ropg/pager/pager.brd

## EAGLE design pager.brd (2017-02-12)

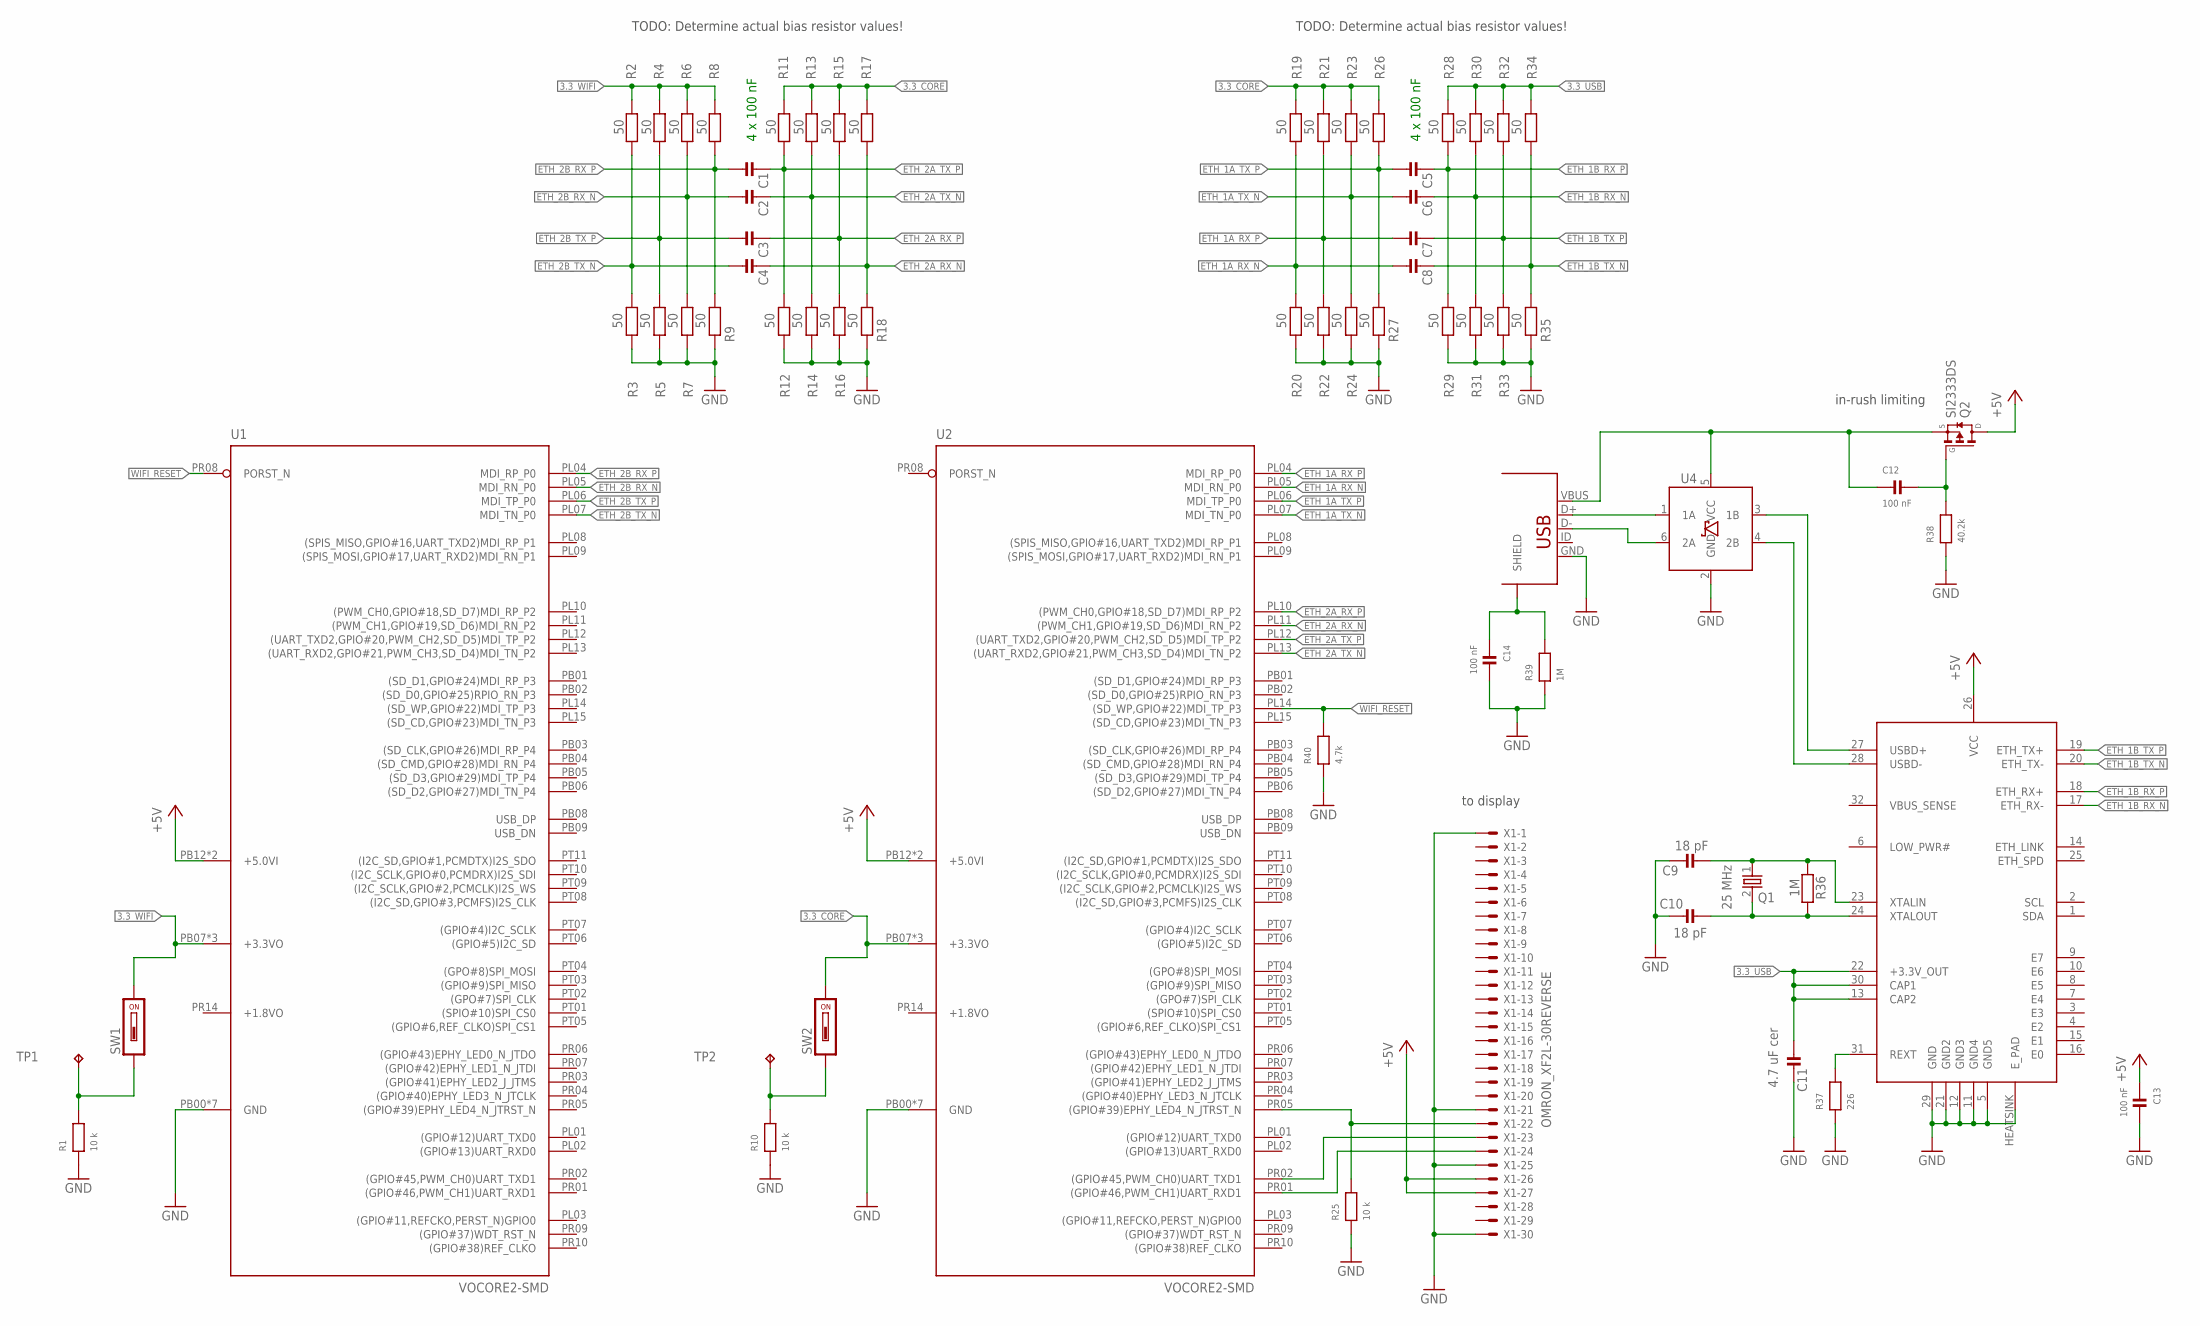
[picture p1: schematic pager.sch]

Parts:
C1, C2, C3, C4, C5, C6, C7, C8, C12, C13, C14: 100 nF; _0402
C9, C10: 18 pF; _0402
C11: 4.7 uF cer; _0603
Q1: 25 MHz; ABM3
Q2: SI2333DS; SOT23
R1, R10, R25: 10 k; _0402
R2, R3, R4, R5, R6, R7, R8, R9, R11, R12, R13, R14, R15, R16, R17, R18, R19, R20, R21, R22, R23, R24, R26, R27, R28, R29, R30, R31, R32, R33, R34, R35: 50; _0402
R36, R39: 1M; _0402
R37: 226; _0402
R38: 40.2k; _0402
R40: 4.7k; _0402
SW1, SW2: CHS-01A1
TP1, TP2: TPTP16SQ; TP16SQ
U1, U2: VOCORE2-SMD
U3: XR22800IL; QFN32
U4: IP4234CZ6; TSOP-6
X1: OMRON_XF2L-30REVERSE; OMRON_XF2L-30
X2: FCI_8193_MICRO_USB; FCI_MICRO_USB_8193

Connections:
3.3_CORE: R11.2, R13.2, R15.2, R17.2, R19.2, R21.2, R23.2, R26.2, SW2.2, U2.PB07 (+3.3VO), U2.PL00 (+3.3VO), U2.PR11 (+3.3VO)
3.3_USB: C11.1, R28.2, R30.2, R32.2, R34.2, U3.13 (CAP2), U3.22 (+3.3V_OUT), U3.30 (CAP1)
3.3_WIFI: R2.2, R4.2, R6.2, R8.2, SW1.2, U1.PB07 (+3.3VO), U1.PL00 (+3.3VO), U1.PR11 (+3.3VO)
+5V: C13.1, Q2.3 (D), U1.PB12 (+5.0VI), U1.PB13 (+5.0VI), U2.PB12 (+5.0VI), U2.PB13 (+5.0VI), U3.26 (VCC), X1.4, X1.5
DISP_RESET: R25.2, U2.PR05 ((GPIO#39)EPHY_LED4_N_JTRST_N), X1.9
DISP_RX0: U2.PR02 ((GPIO#45,PWM_CH0)UART_TXD1), X1.8
DISP_TX0: U2.PR01 ((GPIO#46,PWM_CH1)UART_RXD1), X1.7
ETH_1A_RX_N: C8.1, R19.1, R20.2, U2.PL05 (MDI_RN_P0)
ETH_1A_RX_P: C7.1, R21.1, R22.2, U2.PL04 (MDI_RP_P0)
ETH_1A_TX_N: C6.1, R23.1, R24.2, U2.PL07 (MDI_TN_P0)
ETH_1A_TX_P: C5.1, R26.1, R27.2, U2.PL06 (MDI_TP_P0)
ETH_1B_RX_N: C6.2, R30.1, R31.2, U3.17 (ETH_RX-)
ETH_1B_RX_P: C5.2, R28.1, R29.2, U3.18 (ETH_RX+)
ETH_1B_TX_N: C8.2, R34.1, R35.2, U3.20 (ETH_TX-)
ETH_1B_TX_P: C7.2, R32.1, R33.2, U3.19 (ETH_TX+)
ETH_2A_RX_N: C4.1, R17.1, R18.2, U2.PL11 ((PWM_CH1,GPIO#19,SD_D6)MDI_RN_P2)
ETH_2A_RX_P: C3.1, R15.1, R16.2, U2.PL10 ((PWM_CH0,GPIO#18,SD_D7)MDI_RP_P2)
ETH_2A_TX_N: C2.1, R13.1, R14.2, U2.PL13 ((UART_RXD2,GPIO#21,PWM_CH3,SD_D4)MDI_TN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)
ETH_2A_TX_P: C1.1, R11.1, R12.2, U2.PL12 ((UART_TXD2,GPIO#20,PWM_CH2,SD_D5)MDI_TP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)
ETH_2B_RX_N: C2.2, R6.1, R7.2, U1.PL05 (MDI_RN_P0)
ETH_2B_RX_P: C1.2, R8.1, R9.2, U1.PL04 (MDI_RP_P0)
ETH_2B_TX_N: C4.2, R2.1, R3.2, U1.PL07 (MDI_TN_P0)
ETH_2B_TX_P: C3.2, R4.1, R5.2, U1.PL06 (MDI_TP_P0)
GND: C9.1, C10.1, C11.2, C13.2, C14.2, R1.1, R3.1, R5.1, R7.1, R9.1, R10.1, R12.1, R14.1, R16.1, R18.1, R20.1, R22.1, R24.1, R25.1, R27.1, R29.1, R31.1, R33.1, R35.1, R37.1, R38.1, R39.1, R40.1, U1.PB00 (GND), U1.PB10 (GND), U1.PB11 (GND), U1.PR00 (GND), U1.PR12 (GND), U1.PR13 (GND), U1.PT00 (GND), U2.PB00 (GND), U2.PB10 (GND), U2.PB11 (GND), U2.PR00 (GND), U2.PR12 (GND), U2.PR13 (GND), U2.PT00 (GND), U3.5 (GND5), U3.11 (GND4), U3.12 (GND3), U3.21 (GND2), U3.29 (GND), U3.HEATSINK (E_PAD), U4.2 (GND), X1.1, X1.6, X1.10, X1.30, X2.GND
unnamed: R37.2, U3.31 (REXT)
unnamed: C10.2, Q1.2, R36.2, U3.24 (XTALOUT)
unnamed: C9.2, Q1.1, R36.1, U3.23 (XTALIN)
unnamed: C12.2, Q2.1 (G), R38.2
RAW_+5V: C12.1, Q2.2 (S), U4.5 (VCC), X2.VBUS
SHIELD: C14.1, R39.2, X2.MNT1 (SHIELD), X2.MNT2 (SHIELD), X2.MNT3 (SHIELD), X2.MNT4 (SHIELD), X2.P$1 (SHIELD), X2.P$2 (SHIELD)
USB_N: U3.28 (USBD-), U4.4 (2B)
USB_P: U3.27 (USBD+), U4.3 (1B)
USB_RAW_N: U4.6 (2A), X2.D-
USB_RAW_P: U4.1 (1A), X2.D+
WIFI_RESET: R40.2, U1.PR08 (PORST_N), U2.PL14 ((SD_WP,GPIO#22)MDI_TP_P3)
WP_CORE: R10.2, SW2.1, TP2.TP
WP_WIFI: R1.2, SW1.1, TP1.TP

Notes on the sheet:
in-rush limiting
to display
TODO: Determine actual bias resistor values!
4 x 100 nF

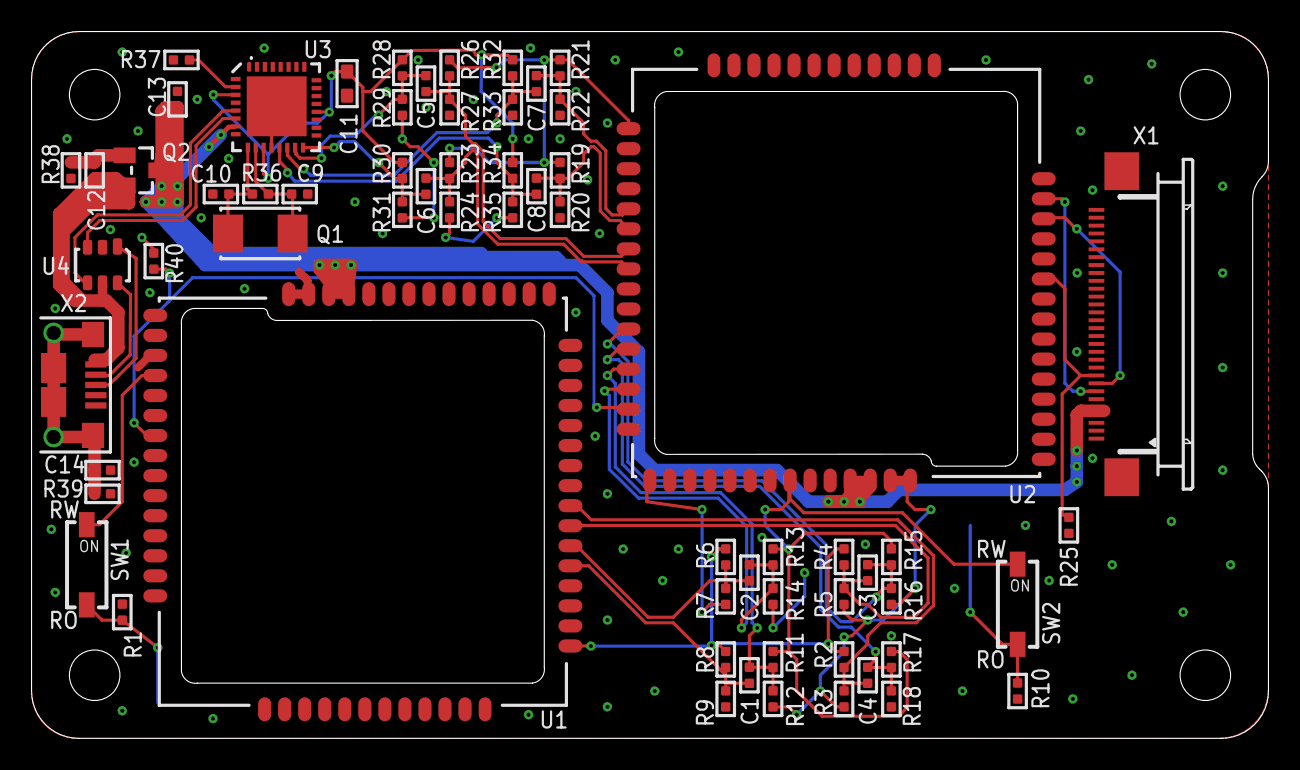
[picture p2: board pager.brd from above]

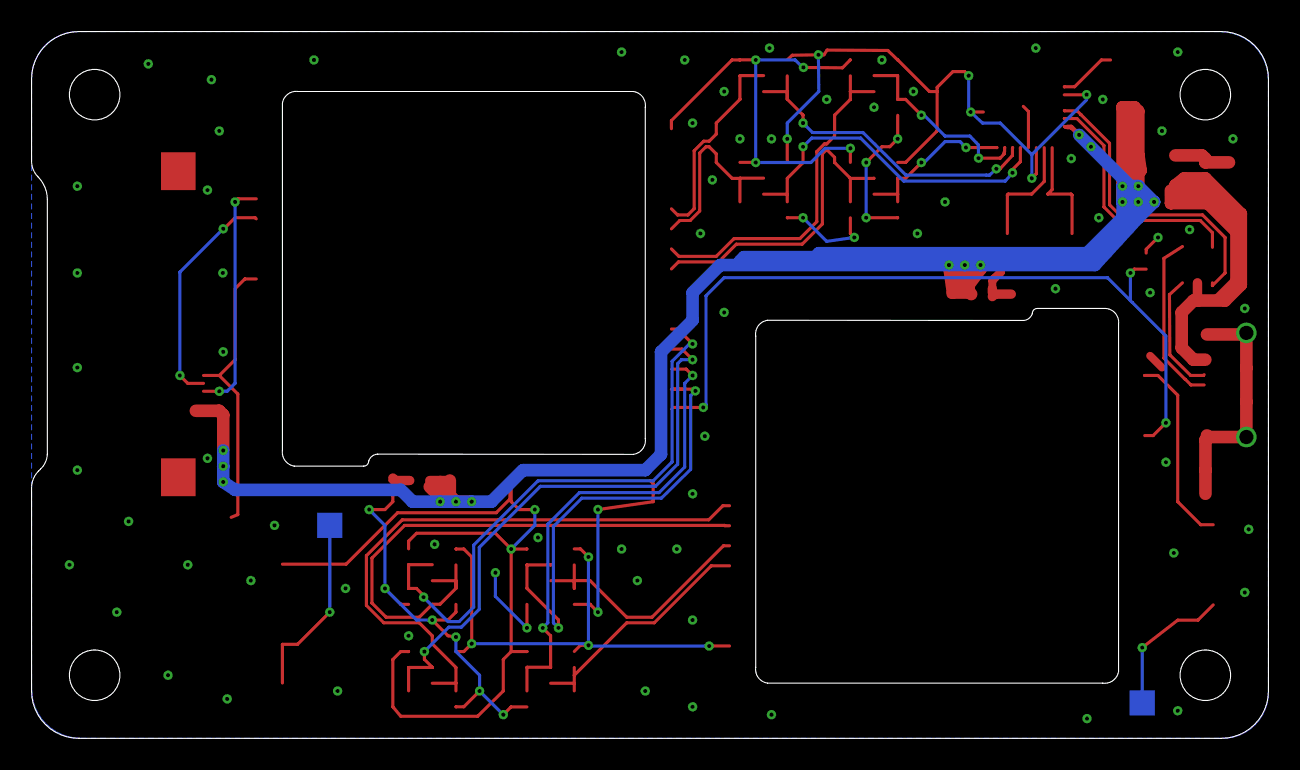
[picture p3: board pager.brd from below]

Board: 2 copper layers, 78.4 x 44.8 mm, 66 parts (2 on the bottom side), 37 nets.
