ropg/pager/(commit log)

2017-01-19 Use 0402/0603 capacitors/resistors
    [pager.sch]
2017-01-19 Add UART test pads; shrink XTAL package
    [pager.sch]
2017-01-19 add some missing junctions in schematics
    [pager.sch]
2017-01-20 Add pull-down resistors for ethernet biasing networks
    Without knowing the internal schematics of the Ethernet PHY driver
    circuitry, we cannot assume that biasing to 3.3V is acceptable for all
    PHYs involved. For a number of PHYs, biasing must be done to 2.1V, for
    example. Hence, we need full resistive dividers to be able to set any
    bias voltage as needed. Actual resistor values TBD by experiments.
    [pager.sch]
2017-01-20 move text notices to Info layer (they should't be in Nets layer)
    [pager.sch]
2017-01-20 Use proper _N and _P suffix for ethernet and USB
    This is what the differential trace router of EAGLE requires for all
    differential traces, otherwise it will not consider the differential
    nature of the signals.
    [pager.sch]
2017-01-20 Introduce Ethernet and USB Net Classes (and put signals in them)
    The trace geometry for differential impedance matching will differ for
    USB and Ethernet, so let's prepare this by putting them into their own
    net classes. Actual geometry still TBD in the net classes at some
    later point.
    [pager.sch]
2017-01-20 placed origin in middle of vocore's, created board and dimensions, placed connectors
    [pager.brd, pager.sch]
2017-01-28 placed parts, various small changes
    Removed test-pads for serial because different port has console and
    vocores come with nice big pads on top
    [pager.brd]
2017-01-28 cosmetic fixes to schematic
    [pager.sch]
2017-01-28 Slightly narrower pads on QFN32 to match design rules
    [pager.brd, pager.sch]
2017-01-28 trying to route
    Will be ripped up, just to see
    [pager.brd, pager.sch]
2017-02-03 Fixed some parts, better placement
    [pager.brd, pager.sch]
2017-02-03 moved R25 for better prototype soldering access
    [pager.brd]
2017-02-04 Added wifi_reset wire, polygons on tRestrict for Vocore's and routed power bus and USB
    [pager.brd, pager.sch]
2017-02-04 5V to USB chip nicer
    [pager.brd]
2017-02-05 moved wire to make ground-plane continue better between U1 and U2
    [pager.brd]
2017-02-06 Newer board file, laforge's tips mostly incorporated
    [pager.brd]
2017-02-06 Some via's were double
    [pager.brd]
2017-02-06 ground plane segments better connected
    [pager.brd]
2017-02-06 fixed a wire too close to pads
    [pager.brd]
2017-02-06 Ground planes even nicer
    [pager.brd]
2017-02-07 Added TVS, resistor and cap between USB-shield and GND, made +5V bus 0.8 mm thick
    [pager.brd, pager.sch]
2017-02-07 minor fixes
    [pager.brd, pager.sch]
2017-02-07 two more GND vias
    [pager.brd]
2017-02-07 various small fixes
    [pager.brd, pager.sch]
2017-02-07 moves to make more space around mounting holes
    [pager.brd]
2017-02-07 Moved vias away from under metallic components
    [pager.brd]
2017-02-07 fix to a trace
    [pager.brd]
2017-02-07 turned off bottom silk screen, minor move of a trace
    [pager.brd]
2017-02-09 moved R25 and fixed a wire that had become an air wire again during a move.
    [pager.brd]
2017-02-10 Fix wire that had come loose.
    [pager.brd]
2017-02-10 vias to 0.25mm drill, 0.6mm diameter
    [pager.brd]
2017-02-12 placed R40 to pull down wifi-reset
    Not sure whether good idea, it's a trade-off. We can always not
    populate.
    [pager.brd, pager.sch]
2017-02-12 added two more vias at +5V feed, moved two vias to make ground plane continuous
    [pager.brd]
2017-02-12 fix drc error
    [pager.brd]
2017-02-12 even thicker power bus
    [pager.brd]
2017-02-12 a few extra ground-plane vias
    [pager.brd]
